tgray-projects/rover/stache_double.stl

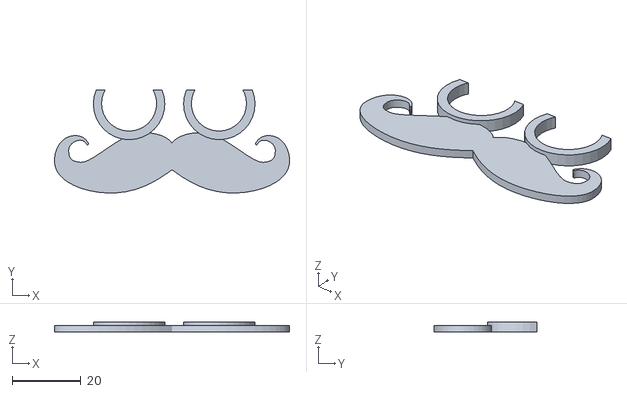
[picture p1: CAD file, 2016-03-07]
stache_double.stl
68.3 x 30.0 x 3.00
