tgray-projects/rover/chassis_large.stl

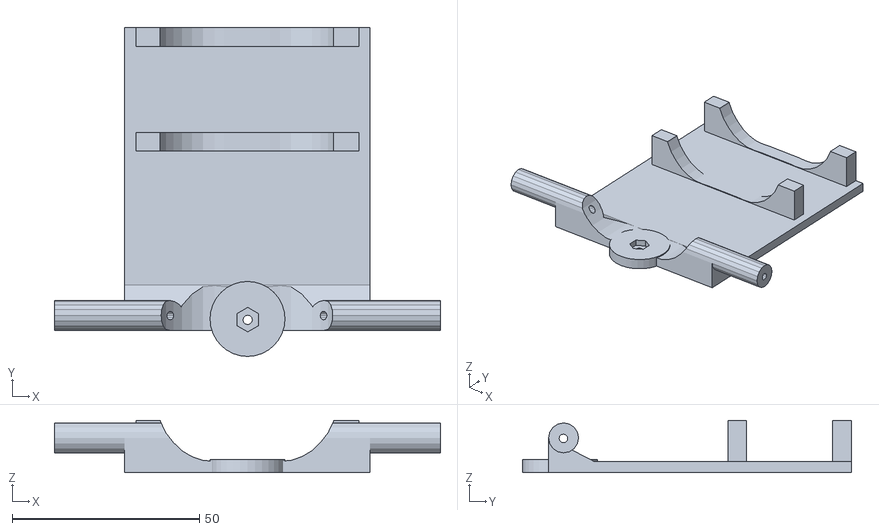
[picture p2: CAD file, 2016-03-07]
chassis_large.stl
103.0 x 87.8 x 14.0
