tgray-projects/rover/wheel_rear_pt1v2.stl

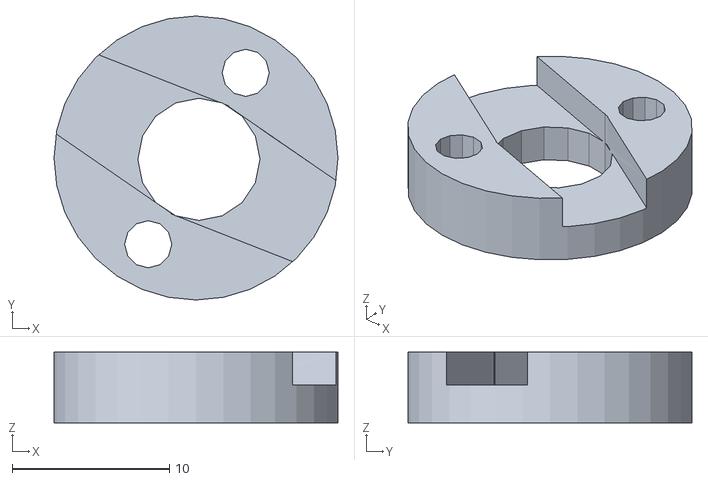
[picture p3: CAD file, 2016-03-07]
wheel_rear_pt1v2.stl
18.1 x 18.1 x 4.50
