tgray-projects/rover/wheel_front.stl

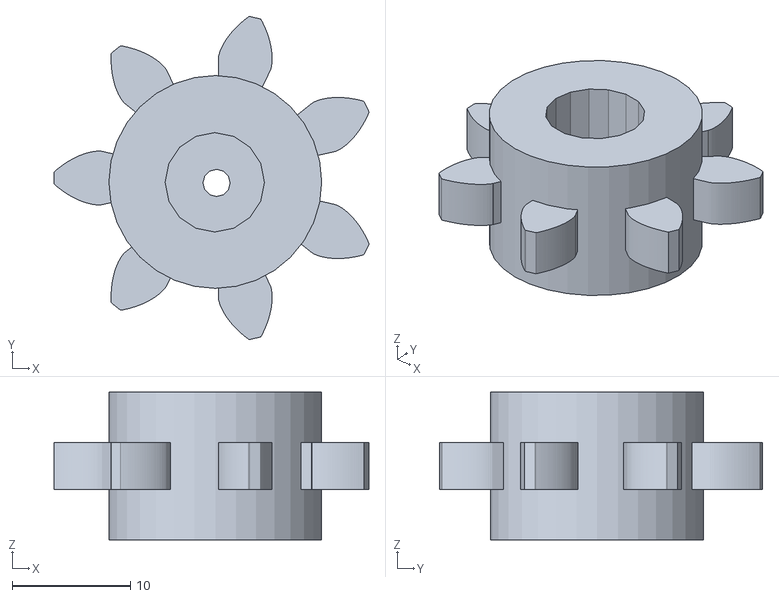
[picture p4: CAD file, 2016-03-07]
wheel_front.stl
26.6 x 27.3 x 12.5
