tgray-projects/rover/sonar_mount_double.stl

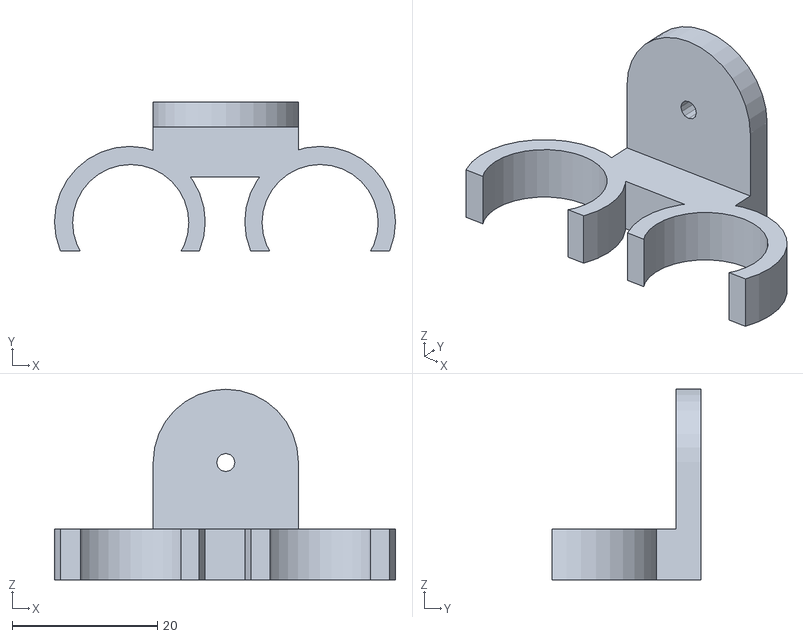
[picture p5: CAD file, 2016-03-07]
sonar_mount_double.stl
47.0 x 20.6 x 26.3
