tgray-projects/rover/wheel_rear_pt2v2.stl

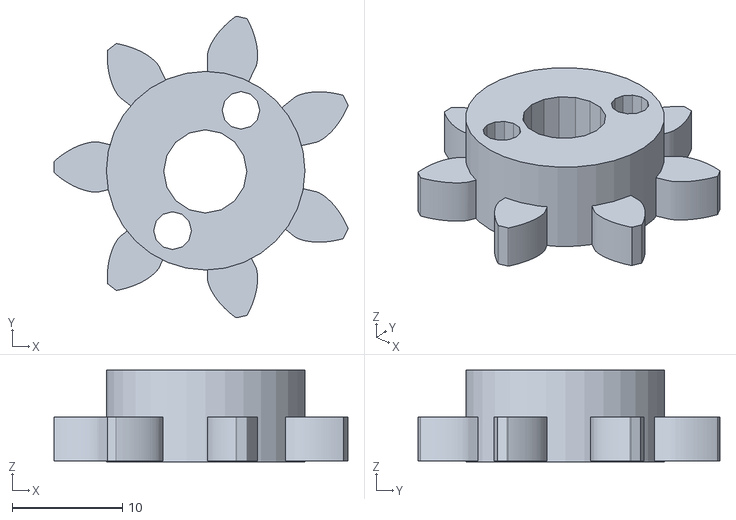
[picture p6: CAD file, 2016-03-07]
wheel_rear_pt2v2.stl
26.6 x 27.3 x 8.30
